alepnm/tcm_module/tiristoriaus_plokste/x2/gamyba/Gamybos specifikacija.txt

2-Layer/FR4 1.6mm/3oz/HAL/Green Soldermask
