alepnm/tcm_module/tcm_modulis/3D/tcm_module.step

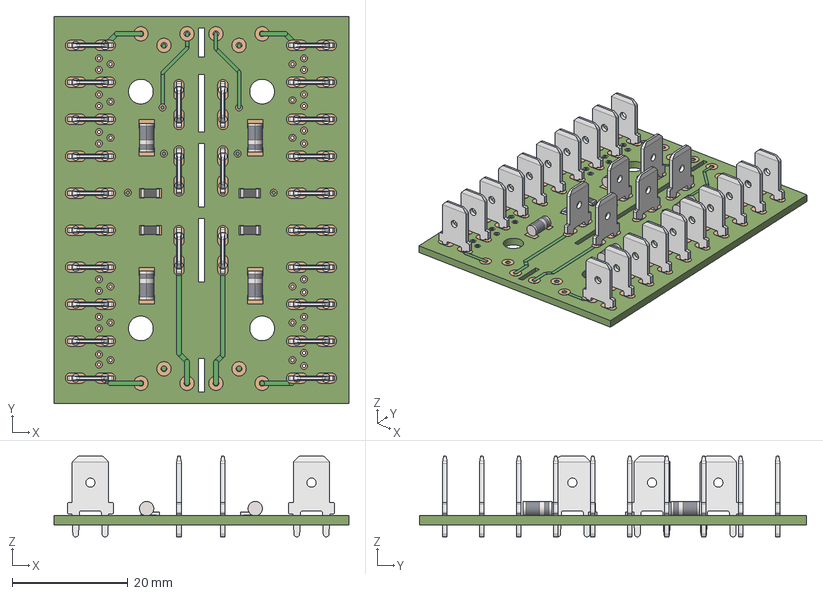
[picture p1: CAD file, 2018-09-27]
tcm_modulis/3D/tcm_module.step
51.0 x 67.0 x 14.0 mm
