alepnm/tcm_module/tiristoriaus_plokste/x2/3d/tp_x2_EKA.FCStd

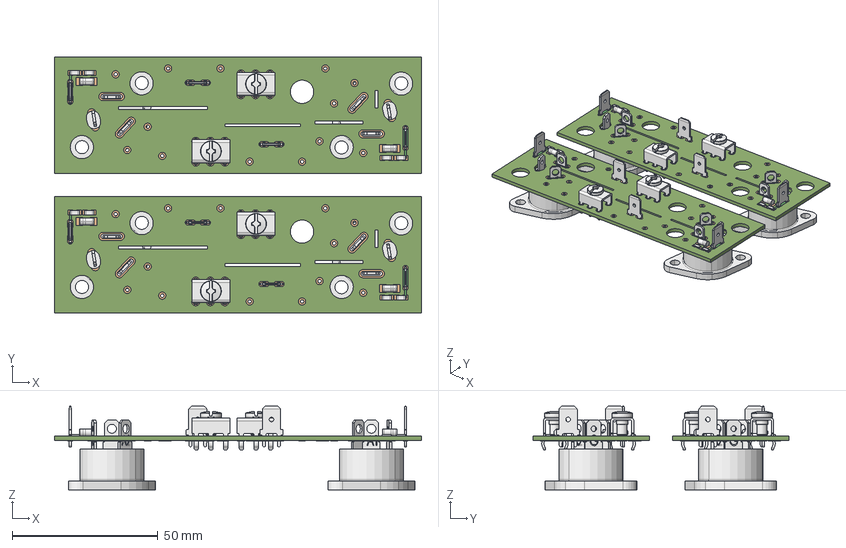
[picture p2: CAD file, 2019-02-07]
tiristoriaus_plokste/x2/3d/tp_x2_EKA.FCStd
126.0 x 88.0 x 28.8 mm
Board
D2
X14
X26
V2.1
V2.2
X6
X17
R1
X5
X4
R4
D1
R2
R3
X3
V1.2
V1.1
D4
X7
X12
D3
R6
R8
R7
R9
X9
X1
X2
F_Cu_0
bPad_107
tPad_108
