alepnm/tcm_module/(list of files, cad)

Other CAD files:
tcm_modulis/3D/tcm_module.FCStd
