alepnm/tcm_module/tiristoriaus_plokste/x1/tp_x1_schematic.pdf

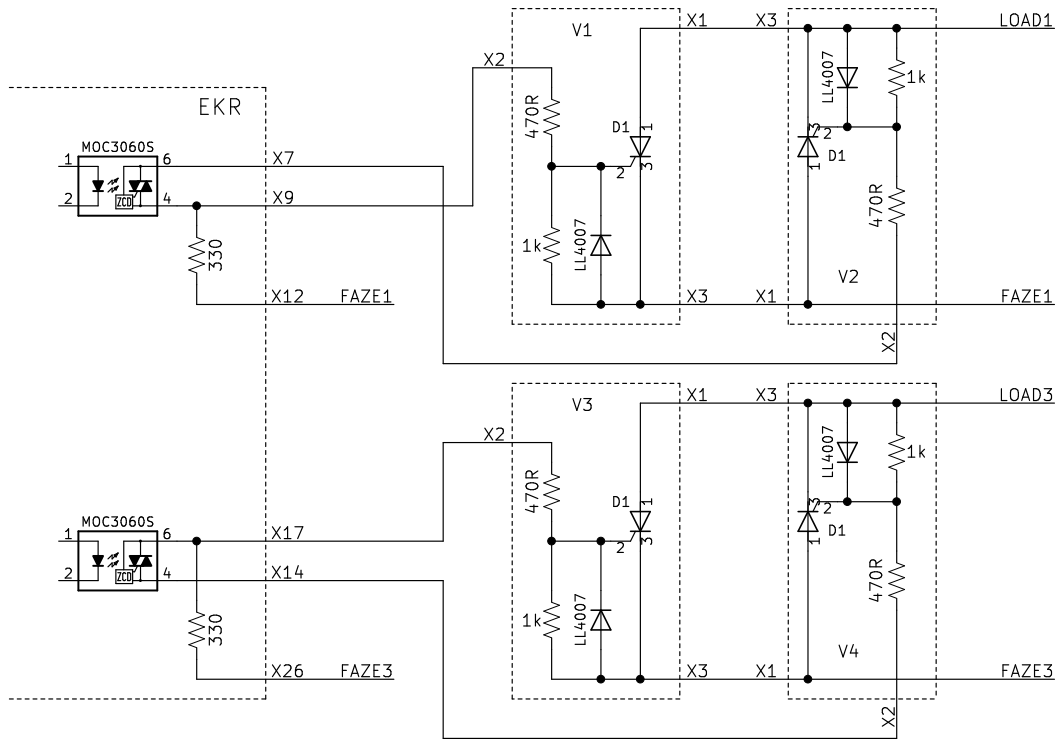
[picture p3: page 1]
