alepnm/tcm_module/tcm_modulis/gamyba/tcm_modulis_pcb.pdf

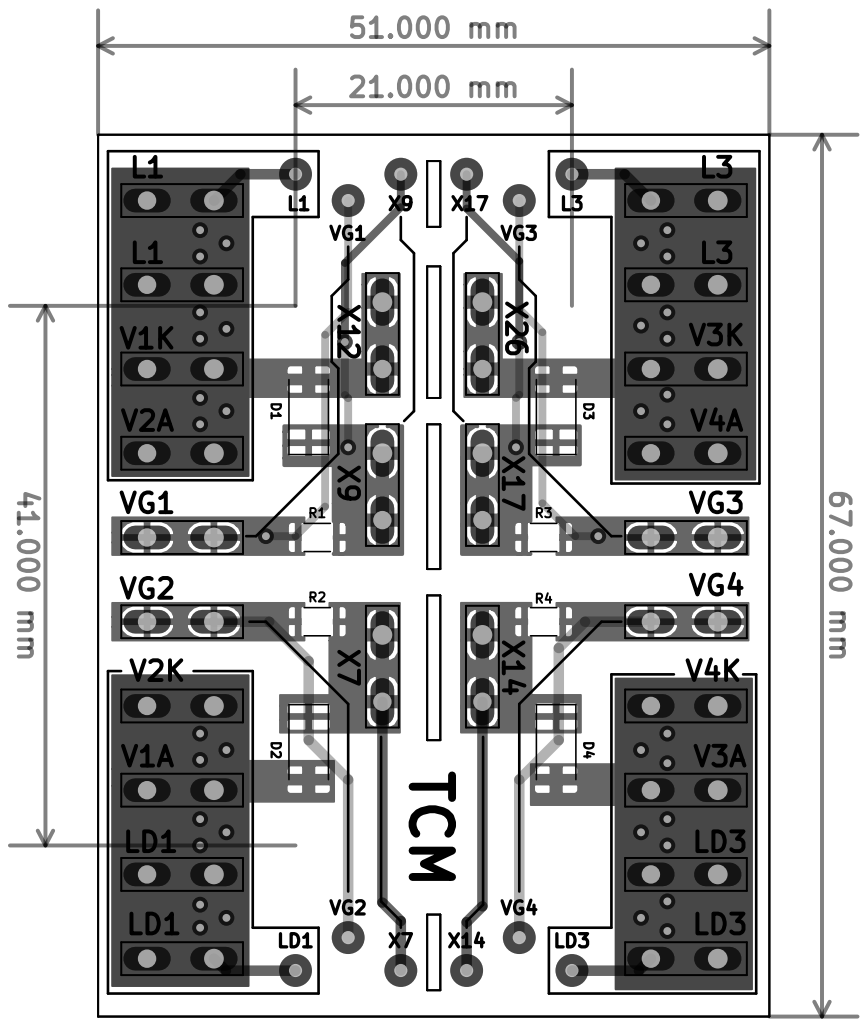
[picture p4: page 1]
