alepnm/tcm_module/tiristoriaus_plokste/x2/gamyba/tiristoriu_plokste_EKA.pdf

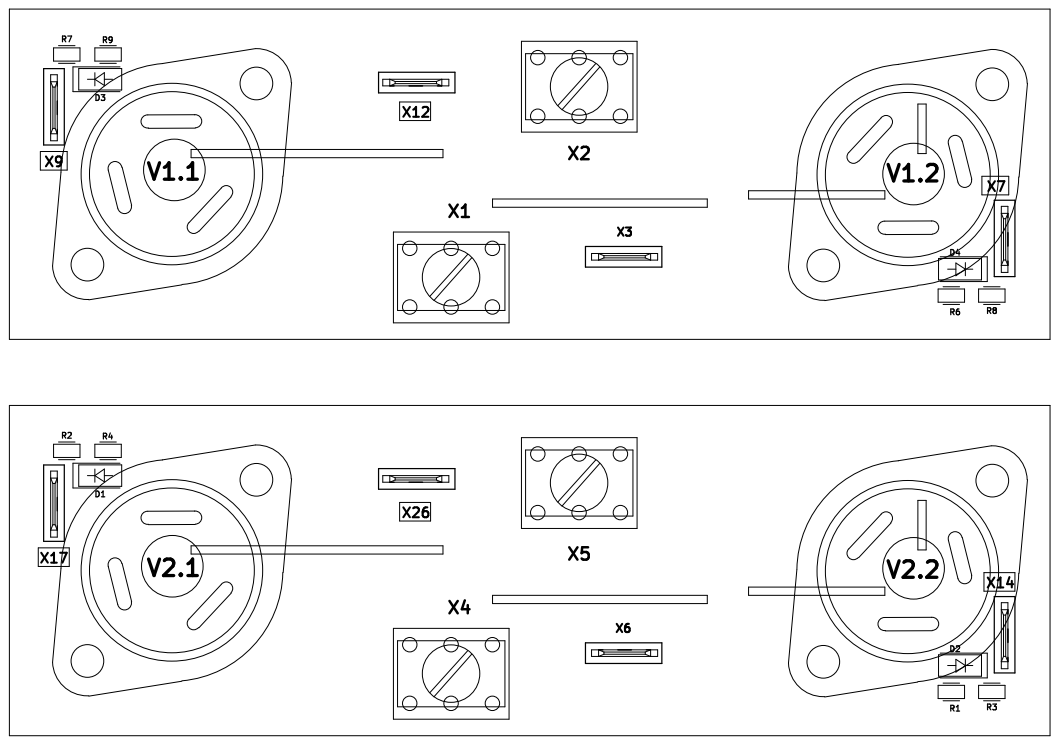
[picture p5: page 1]
