alepnm/tcm_module/tiristoriaus_plokste/x2/gamyba/tiristoriu_plokste.pdf

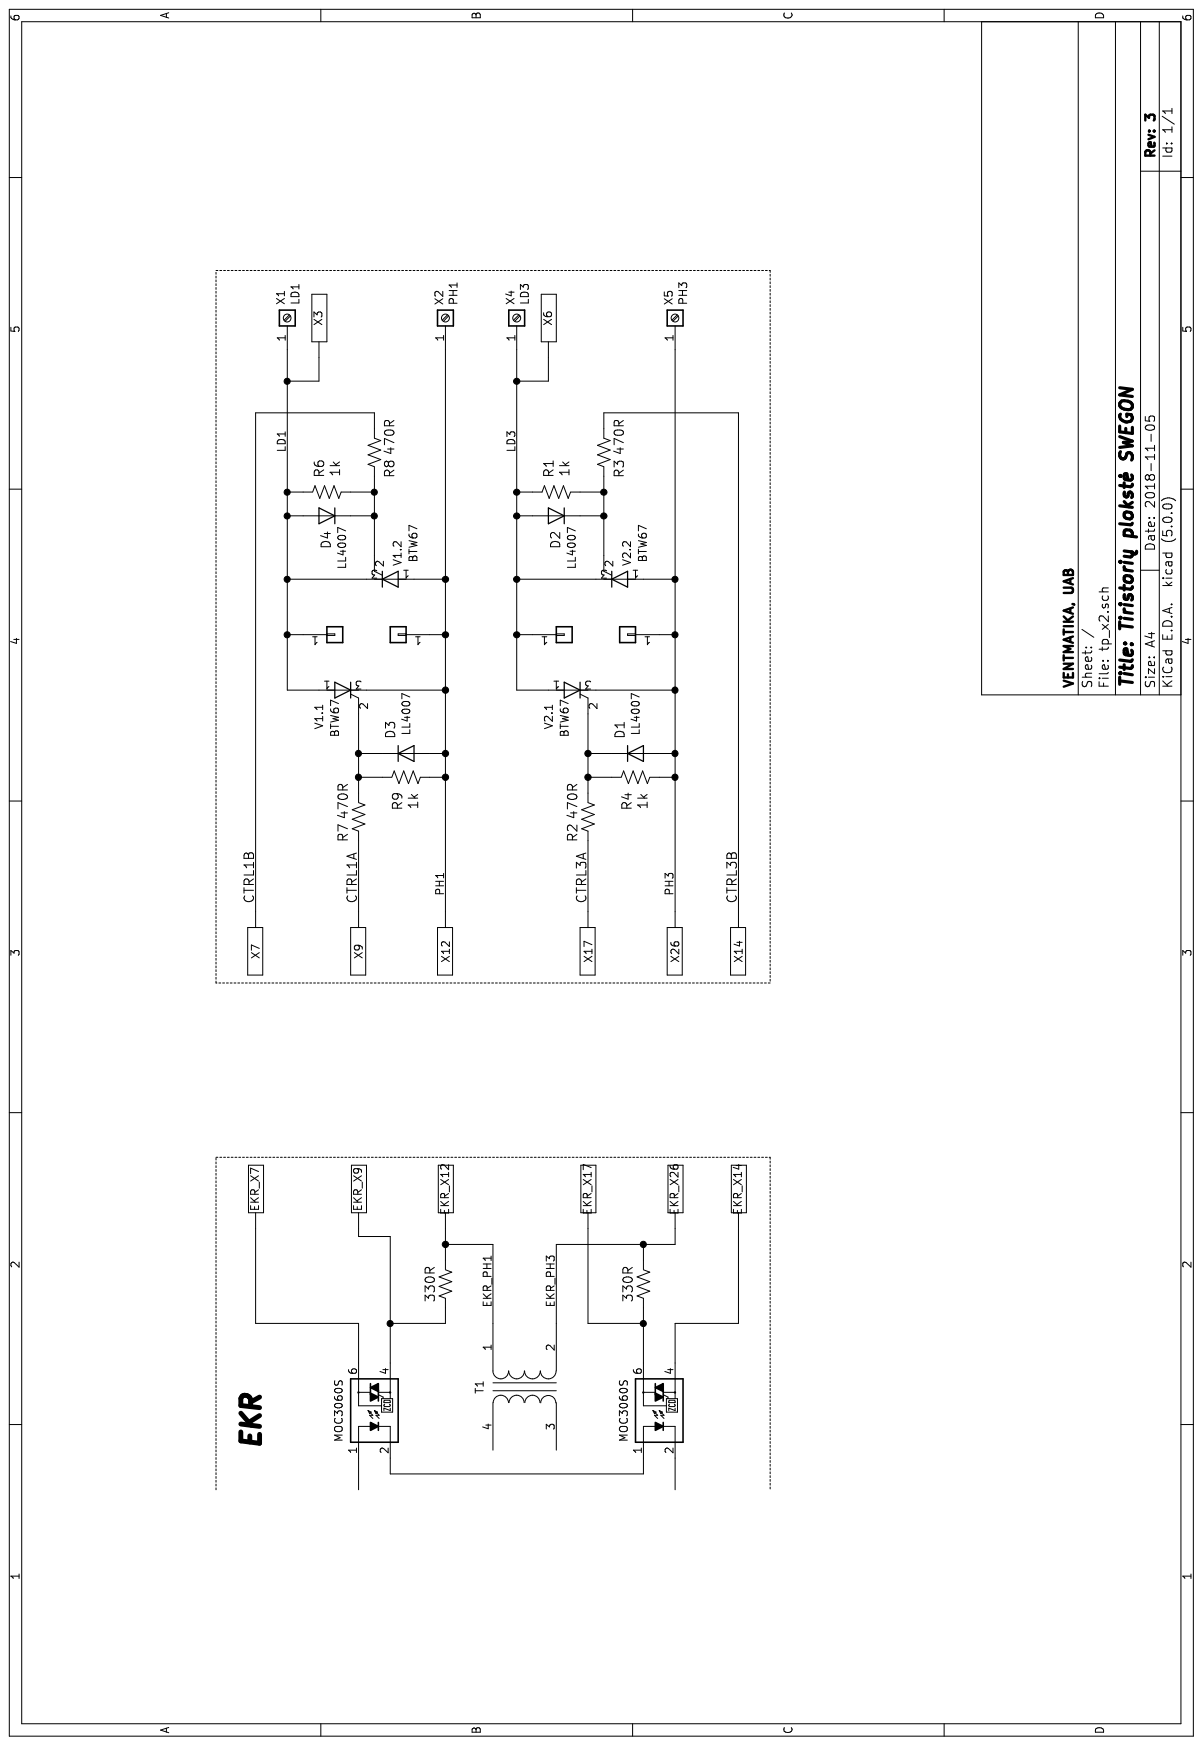
[picture p6: page 1]

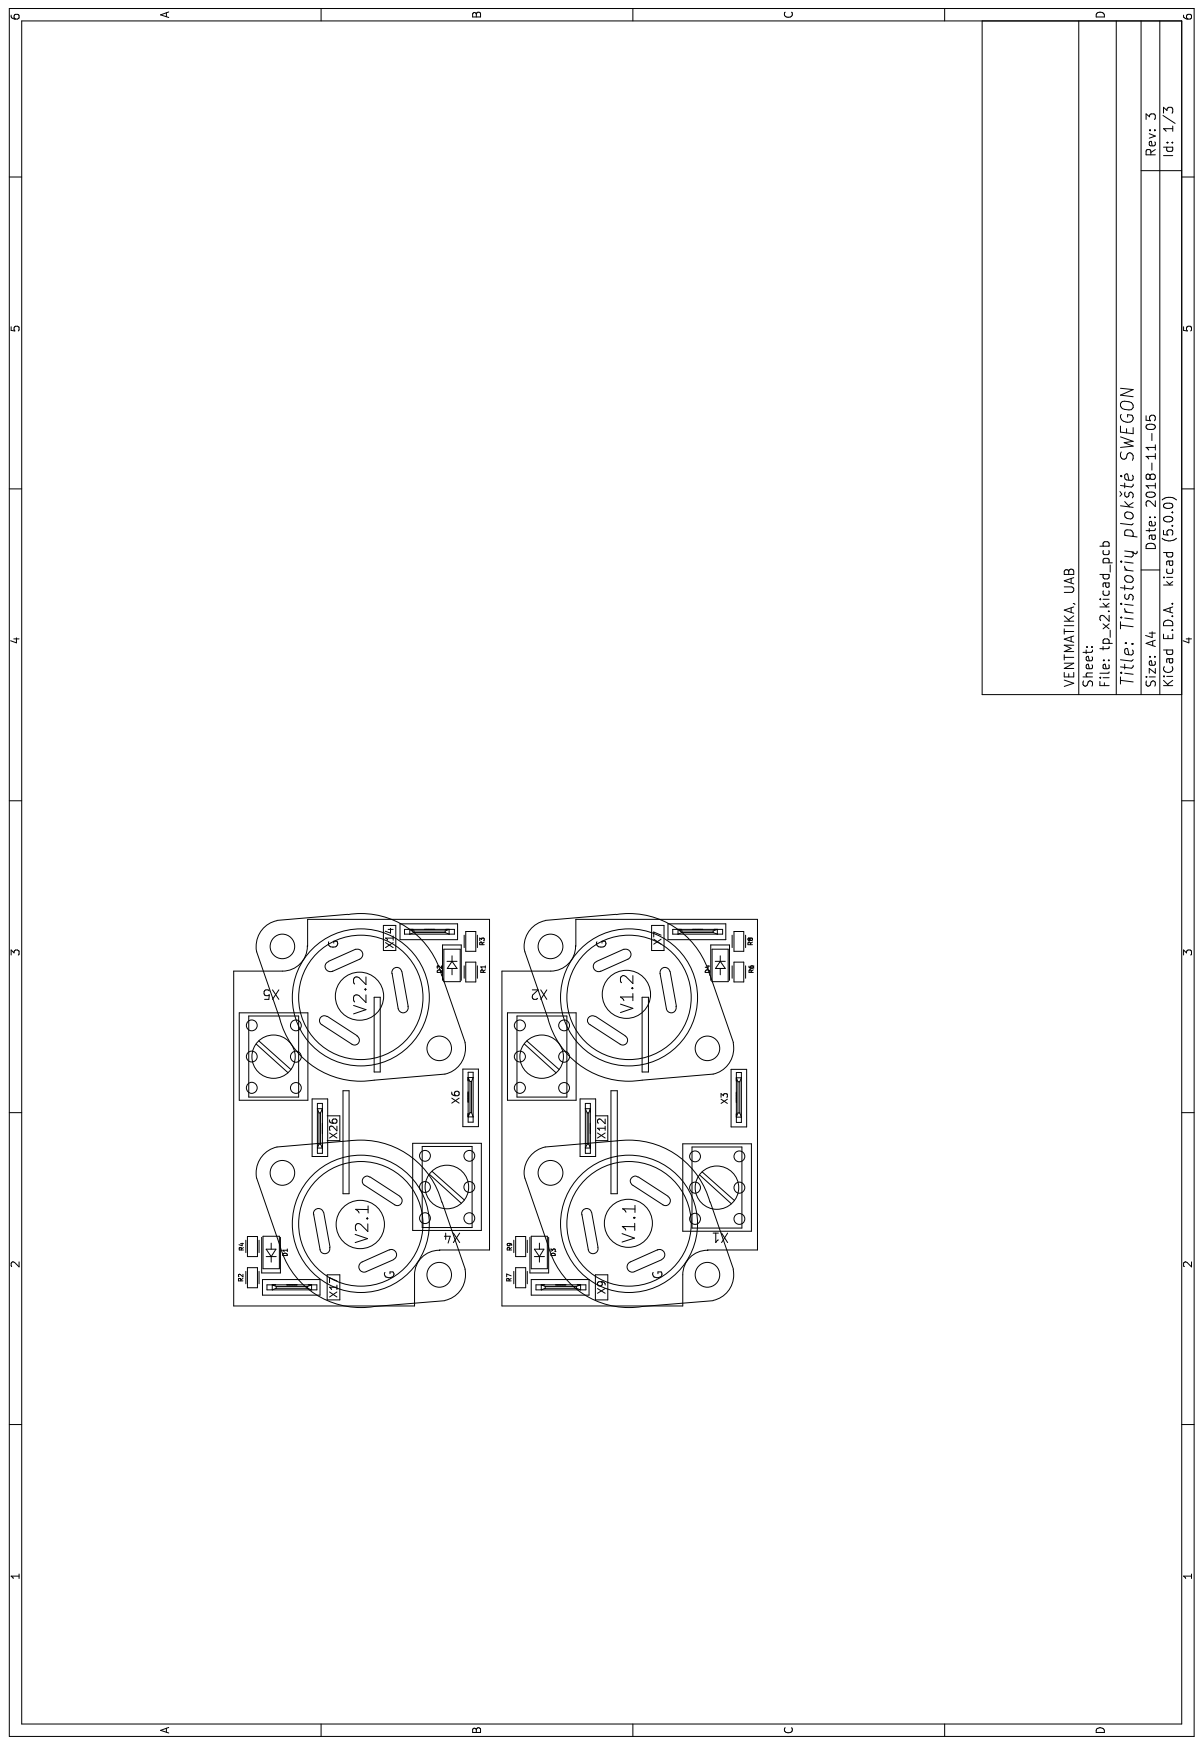
[picture p7: page 2]
