alepnm/tcm_module/tiristoriaus_plokste/x2/tp_x2.kicad_pcb

## KiCad design tiristoriaus_plokste/x2/tp_x2.kicad_pcb (2019-02-07)

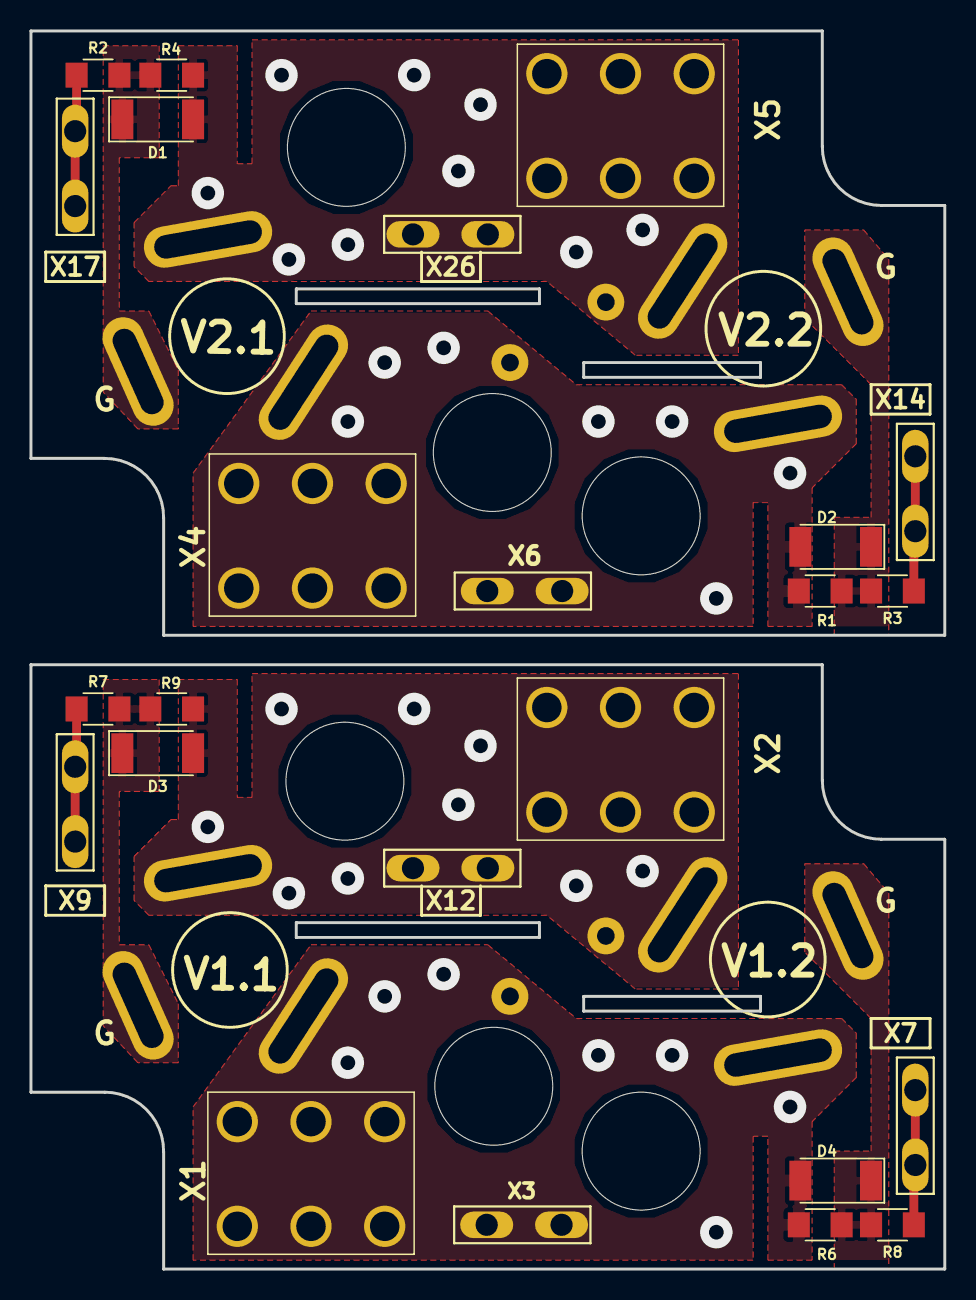
[picture p8: board tp_x2.kicad_pcb from above]

Board: 2 copper layers, 62.0 x 84.0 mm, 32 parts (0 on the bottom side), 12 nets.

Parts:
D1, D2, D3, D4: LL4007; D_MELF
H1, H2, H3, H4: Conn_01x01; SolderWirePad_single_1mmDrill
R1, R4, R6, R9: 1k; R_1206
R2, R3, R7, R8: 470R; R_1206
V1.1, V1.2, V2.1, V2.2: BTW67; RD91
X1: LD1; Solder_Terminal_M3
X2: PH1; Solder_Terminal_M3
X3, X6, X7, X9, X12, X14, X17, X26: Faston_6.3x08x14; Faston_6.3x0.8x14
X4: LD3; Solder_Terminal_M3
X5: PH3; Solder_Terminal_M3

Connections:
/CTRL1A: R7.1, X9.1
/CTRL1B: R8.1, X7.1
/CTRL3A: R2.1, X17.1
/CTRL3B: R3.1, X14.1
/LD1: D4.2, H1.1, R6.1, V1.1.1, V1.2.3, X1.1, X3.1
/LD3: D2.2, H3.1, R1.1, V2.1.1, V2.2.3, X4.1, X6.1
/PH1: D3.2, H2.1, R9.1, V1.1.3, V1.2.1, X2.1, X12.1
/PH3: D1.2, H4.1, R4.1, V2.1.3, V2.2.1, X5.1, X26.1
unnamed: D1.1, R2.2, R4.2, V2.1.2
unnamed: D2.1, R1.2, R3.2, V2.2.2
unnamed: D3.1, R7.2, R9.2, V1.1.2
unnamed: D4.1, R6.2, R8.2, V1.2.2
