alepnm/tcm_module/tcm_modulis/tcm_modulis.kicad_pcb

## KiCad design tcm_modulis/tcm_modulis.kicad_pcb (2018-07-04)

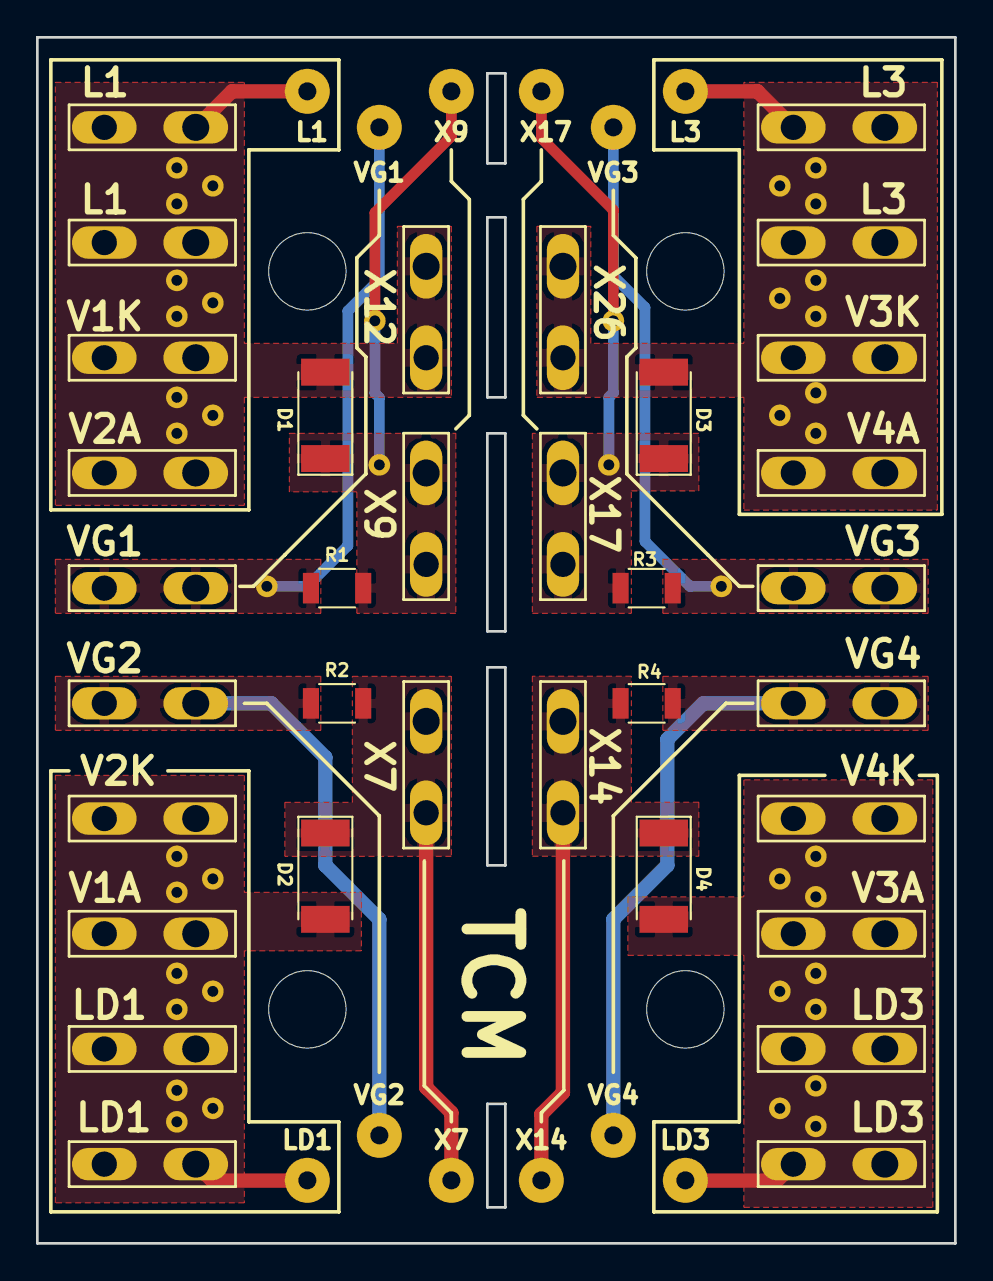
[picture p9: board tcm_modulis.kicad_pcb from above]

Board: 2 copper layers, 51.0 x 67.0 mm, 34 parts (0 on the bottom side), 12 nets.

Parts:
D1, D2, D3, D4: LL4007; D_MELF
L11, L12, L31, L32: Faston_6.3x08x14; Faston_6.3x0.8x14
LD11, LD12, LD31, LD32: Faston_6.3x08x14; Faston_6.3x0.8x14
R1, R2, R3, R4: 330R; R_1206
V1A1, V1K1, V2A1, V2K1, V3A1, V3K1, V4A1, V4K1: Faston_6.3x08x14; Faston_6.3x0.8x14
VG1, VG2, VG3, VG4: Faston_6.3x08x14; Faston_6.3x0.8x14
X7, X9, X12, X14, X17, X26: Faston_6.3x08x14; Faston_6.3x0.8x14

Connections:
/IN1: D1.1, R1.2, X9.1
/IN2: D2.1, R2.2, X7.1
/IN3: D3.1, R3.2, X17.1
/IN4: D4.1, R4.2, X14.1
/L1: D1.2, L11.1, L12.1, V1K1.1, V2A1.1, X12.1
/L3: D3.2, L31.1, L32.1, V3K1.1, V4A1.1, X26.1
/LD1: D2.2, LD11.1, LD12.1, V1A1.1, V2K1.1
/LD3: D4.2, LD31.1, LD32.1, V3A1.1, V4K1.1
/VG1: R1.1, VG1.1
/VG2: R2.1, VG2.1
/VG3: R3.1, VG3.1
/VG4: R4.1, VG4.1
