alepnm/tcm_module/tiristoriaus_plokste/x1/tp_x1.kicad_pcb

## KiCad design tiristoriaus_plokste/x1/tp_x1.kicad_pcb (2018-10-11)

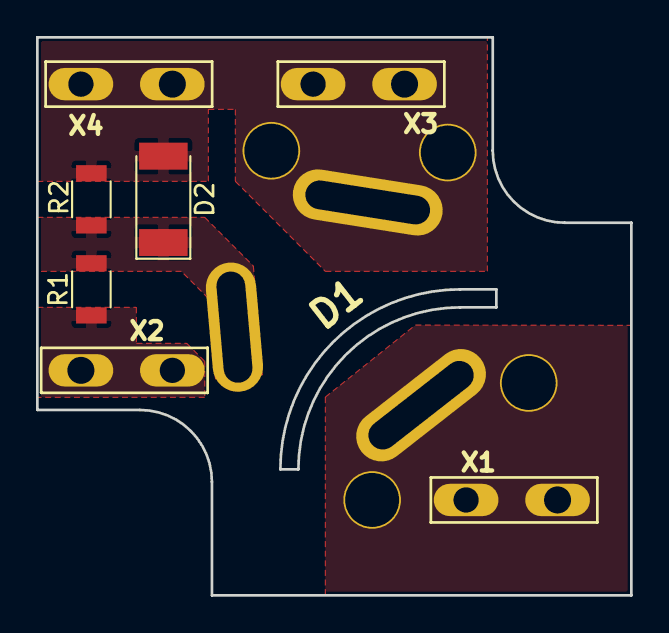
[picture p10: board tp_x1.kicad_pcb from above]

Board: 2 copper layers, 33.0 x 31.0 mm, 8 parts (0 on the bottom side), 4 nets, no tracks yet.

Parts:
D1: BTW67; RD91
D2: LL4007; D_MELF
R1: 470R; R_1206
R2: 1k; R_1206
X1: A; Faston_6.3x0.8x14
X2, X4: Faston_6.3x08x14; Faston_6.3x0.8x14
X3: K; Faston_6.3x0.8x14

Connections:
/A: D1.1, X1.1
/C: D1.3, D2.2, R2.1, X3.1, X4.1
/CTRL: R1.1, X2.1
unnamed: D1.2, D2.1, R1.2, R2.2
