alepnm/tcm_module/tiristoriaus_plokste/x2/tp_x2.sch

## KiCad design tiristoriaus_plokste/x2/tp_x2.sch (2019-04-29, an earlier design)

Schematic: tp_x2.sch

Parts:
D1, D2, D3, D4: LL4007; D_MELF
EKR_X7, EKR_X9, EKR_X12: Faston_6.3x08x14
EKR_X14: X14
EKR_X17: X17
EKR_X26: X26
H1, H2, H3, H4: Conn_01x01; SolderWirePad_single_1mmDrill
R1, R4, R6, R9: 1k; R_1206
R2, R3, R7, R8: 470R; R_1206
R5, R10: 330R
T1: Transformer_1P_1S
U1, U2: MOC3060S
V1.1, V1.2, V2.1, V2.2: BTW67; RD91
X1: LD1; Solder_Terminal_M3
X2: PH1; Solder_Terminal_M3
X3, X6, X7, X9, X12, X14, X17, X26: Faston_6.3x08x14; Faston_6.3x0.8x14
X4: LD3; Solder_Terminal_M3
X5: PH3; Solder_Terminal_M3

Notes on the sheet:
EKR
