alepnm/tcm_module/(commit log)

2018-07-04 pradine inicializacija
    [tcm_modulis.kicad_pcb, tcm_modulis.sch]
2018-07-04 sugeneruoti gerberiai
    [tcm_modulis-B.Cu.gbr, tcm_modulis-B.Mask.gbr, tcm_modulis-Edge.Cuts.gbr, tcm_modulis-F.Cu.gbr, tcm_modulis-F.Mask.gbr, tcm_modulis-F.SilkS.gbr, tcm_modulis-NPTH.drl, tcm_modulis.drl]
2018-07-04 paruosta surinkimo schema
    [tcm_modulis.kicad_pcb]
2018-09-27 nauja tiristoriu plokste. 3d step failas tcm modulio
    [tcm_module.FCStd, tcm_module.step, tiristoriaus_plokste.kicad_pcb, tiristoriaus_plokste.sch]
2018-10-05 pataisyti RD91 futprinto kontaktai, schemoje papiestos lygiagretaus simistoriu pajungimo schemos, ir komutavimas jais trifaziu apkrovu
    [tiristoriaus_plokste-B.Cu.gbr, tiristoriaus_plokste-B.Mask.gbr, tiristoriaus_plokste-Edge.Cuts.gbr, tiristoriaus_plokste-F.Cu.gbr, tiristoriaus_plokste-F.Mask.gbr, tiristoriaus_plokste-F.SilkS.gbr, tiristoriaus_plokste-drl_map.gbr, tiristoriaus_plokste.drl]
2018-10-11 plokstes dviem tiristoriams projektavimas. gerber failu ruosimas gamybai
    [dviguba_plokste.FCStd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]
2018-10-18 paruosti failai gamybai
    [dviguba_plokste.FCStd, dviguba_plokste.kicad_pcb, dviguba_plokste.sch, tp_x1.kicad_pcb, tp_x1.sch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]
2018-11-05 sugeneruoti nauji gerberiai, paruostos principine ir surinkimo schemos.
    [tcm_module.FCStd, tcm_module.step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]
2018-11-05 sugeneruoti nauji gerberiai, paruostos principine, komponentu isdestymo ir surinkimo schemos.
    [tcm_module.FCStd, tcm_module.step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]
2018-11-19 paskutinis variantas. sugeneruoti nauji gerberiai
    [tp_x2-B.Cu.gbr, tp_x2-B.Mask.gbr, tp_x2-Eco1.User.gbr, tp_x2-Edge.Cuts.gbr, tp_x2-F.Cu.gbr, tp_x2-F.Mask.gbr, tp_x2-F.Paste.gbr, tp_x2-F.SilkS.gbr]
2018-12-19 tiristoriu plokste EKA'ms
    [tp_x2_EKA-B.Cu.gbr, tp_x2_EKA-B.Mask.gbr, tp_x2_EKA-Edge.Cuts.gbr, tp_x2_EKA-F.Cu.gbr, tp_x2_EKA-F.Mask.gbr, tp_x2_EKA-F.Paste.gbr, tp_x2_EKA-F.SilkS.gbr, tp_x2_EKA.drl]
2019-02-07 failai gamybai: peek&place, nauji gerberiai - panelei, breziniai
    [tp_x1.sch, tp_x2.brd, tp_x2.kicad_pcb, tp_x2_EKA.FCStd, tp_x2_EKA.kicad_pcb, tp_x2_PnP-top.csv, tp_x2_PnP.kicad_pcb]
2019-02-08 paruosta gamybai - plokstes sugrupuoti panelemis, paruosti peek-and-place failai
    [tp_x2-B.Cu.gbr, tp_x2-B.Mask.gbr, tp_x2-Eco1.User.gbr, tp_x2-Edge.Cuts.gbr, tp_x2-F.Cu.gbr, tp_x2-F.Mask.gbr, tp_x2-F.Paste.gbr, tp_x2-F.SilkS.gbr]
2019-02-20 pasalinti nereikalingi failai
    [tiristoriaus_plokste.FCStd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]
